koba3nmnr/wifiCar/parts.JPG

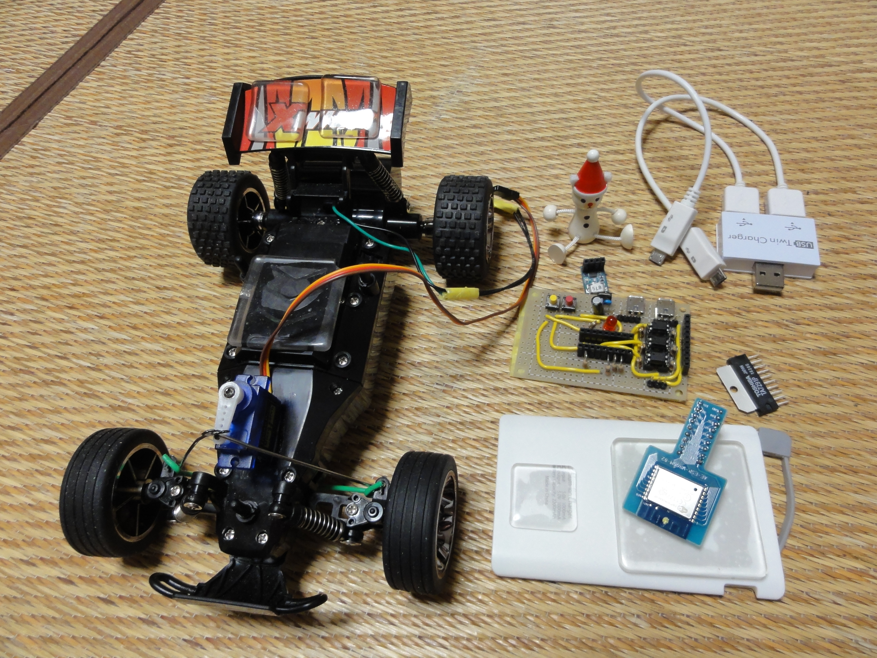
parts.JPG
