koba3nmnr/wifiCar/substrate2.JPG

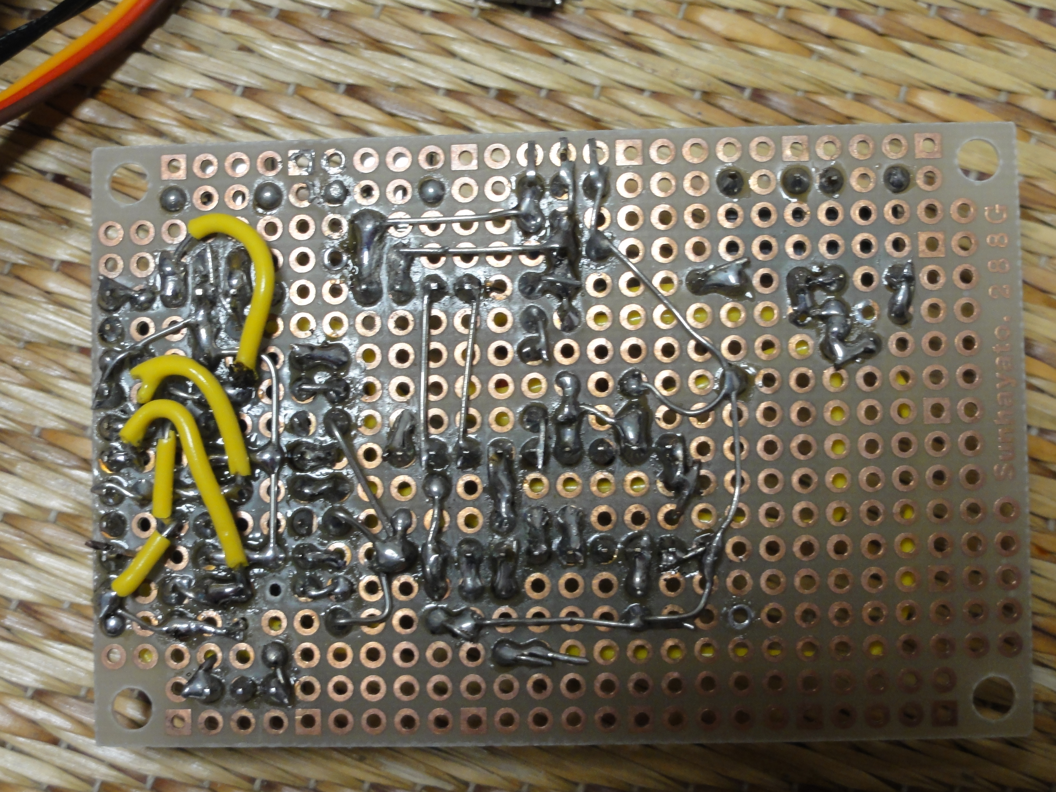
substrate2.JPG
