koba3nmnr/wifiCar/wifiCar_ElectronicCircuitDiagram.pdf

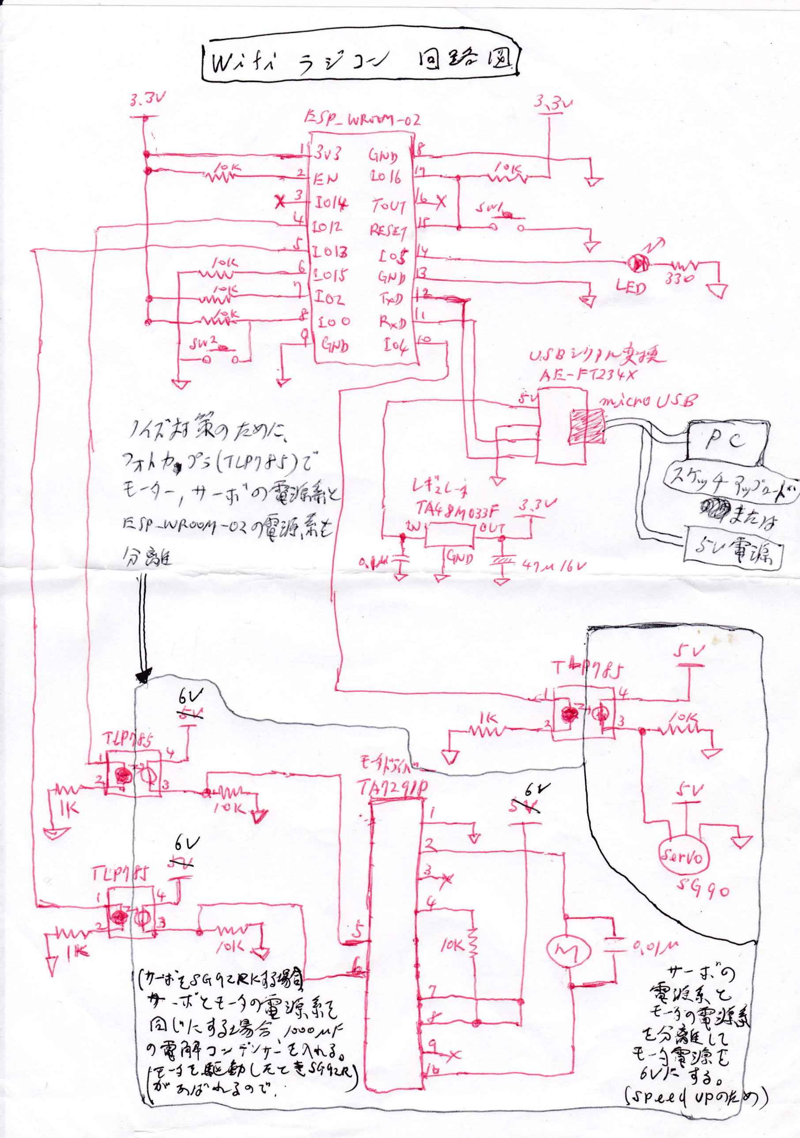
[picture p3: page 1]

げメ ス ラジ〕ノ 1■ Z`多 ユ

、7プ
| Efr* hrF^n4-02

J、タツ

_イ/′

L二

### じ イクノルカえ

Aた一片 2フ 学
クスメ じ ごL′

ごレlL._

33´

レ41ι 材

### 4牛 夕4 oyf

`、

ァノ

0レ

へ[μ
ヽン

い
|リ
年,′ /ι レ

ノ。ヽ

Gトン |
b∫

饂^υJlこ~
上。ご

Q″タ

1卜|ク
Rバタ

20`ι

プ

。13

G″

た
こ041

1012

=ofr

6‐
|■00

J●

分え色

|く

晨 | _″
fPヽ | カーR′1暉〃多t魚

### ノイァアプ象の りたも ら1ち ル(イ フJ｀

1))Z"

'~ノ

### サ 手・の1秒鶴

|ト

了11′

、rν

7(た「

ご⁾⁰⁹。

ノつ 麟く、

ぶ`ノ

6ノ
夢く

モイ

`/

・累

/。 |く | 、⁰ノン
す
資貶

ヤ
Vヽ (7-a lrei ,1ae | つ
サ | tハ | ヒモ つの脅 場ゲ 颯
イ
ン
ヽ ヽ

し

ti | ぢ

て
し | そ | ス

ヽ

ノ。つ。 〆 | t,
へ代

鮭 し
タ | モ | イ
| | し
え | び | ず

り

ら

ヘ」ヽぶつ ぜ

ク1つ

pι認 げ

|に

ヽ、
ノ
