koba3nmnr/wifiCar/ESP-WROOM-02.JPG

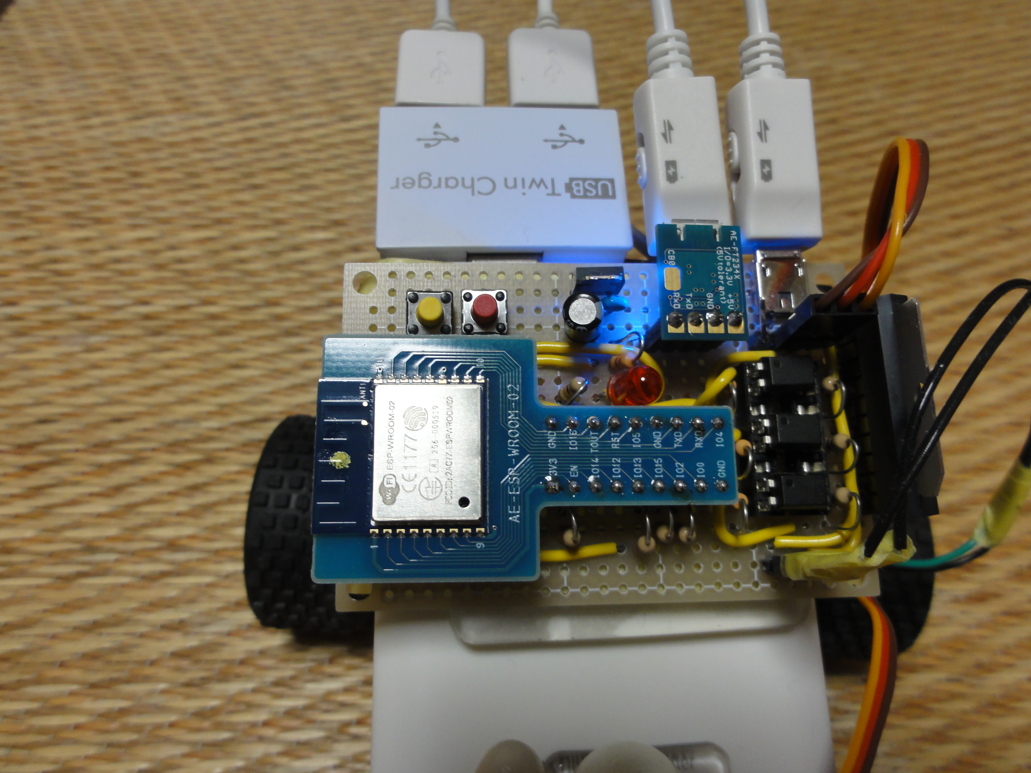
ESP-WROOM-02.JPG
