koba3nmnr/wifiCar/smartPhone.JPG

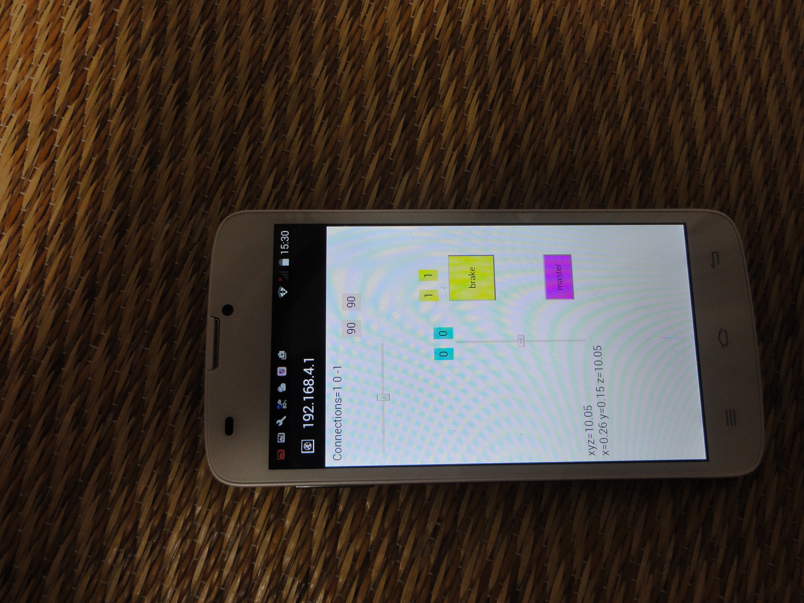
smartPhone.JPG
