koba3nmnr/wifiCar/substrate1.JPG

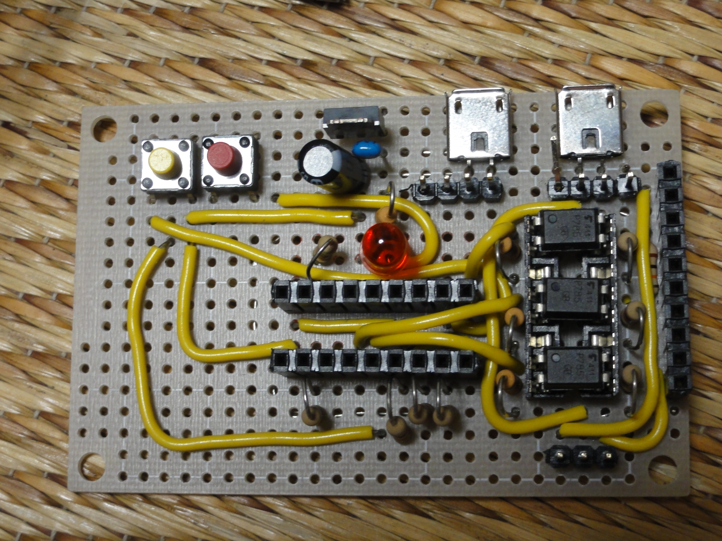
substrate1.JPG
