koba3nmnr/wifiCar/wifiCar.JPG

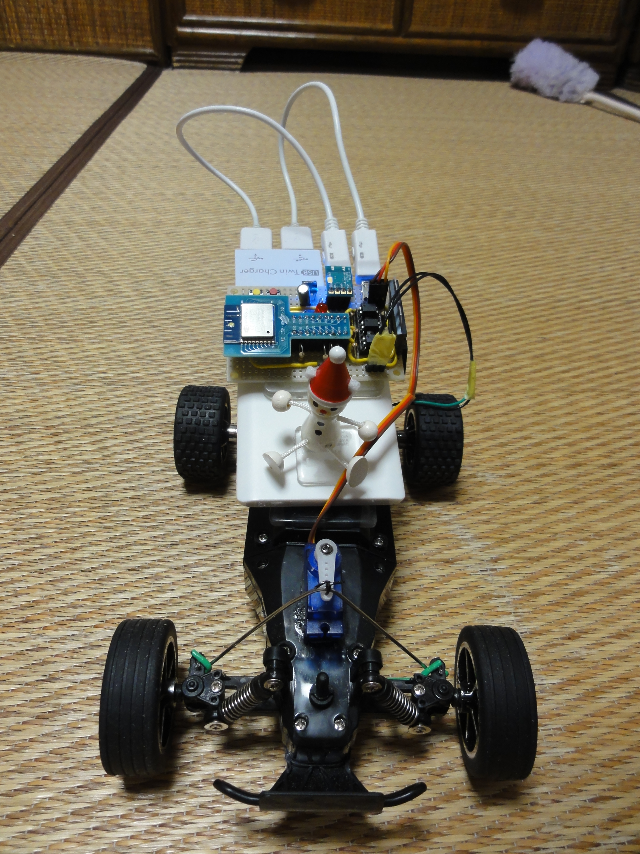
wifiCar.JPG
